adafruit/Adafruit-PyGamer-PCB/README.md

# Adafruit-PyGamer-PCB
PCB files for Adafruit PyGamer

Format is EagleCAD schematic and board layout

For more details, check out the product page at

   * https://www.adafruit.com/product/4242

Adafruit invests time and resources providing this open source design, 
please support Adafruit and open-source hardware by purchasing 
products from Adafruit!

Designed by Adafruit Industries.  
Creative Commons Attribution, Share-Alike license, check license.txt for more information
All text above must be included in any redistribution
