adafruit/Adafruit-PyGamer-PCB/Adafruit PyGamer.sch

## EAGLE design Adafruit PyGamer.sch (2019-05-22)

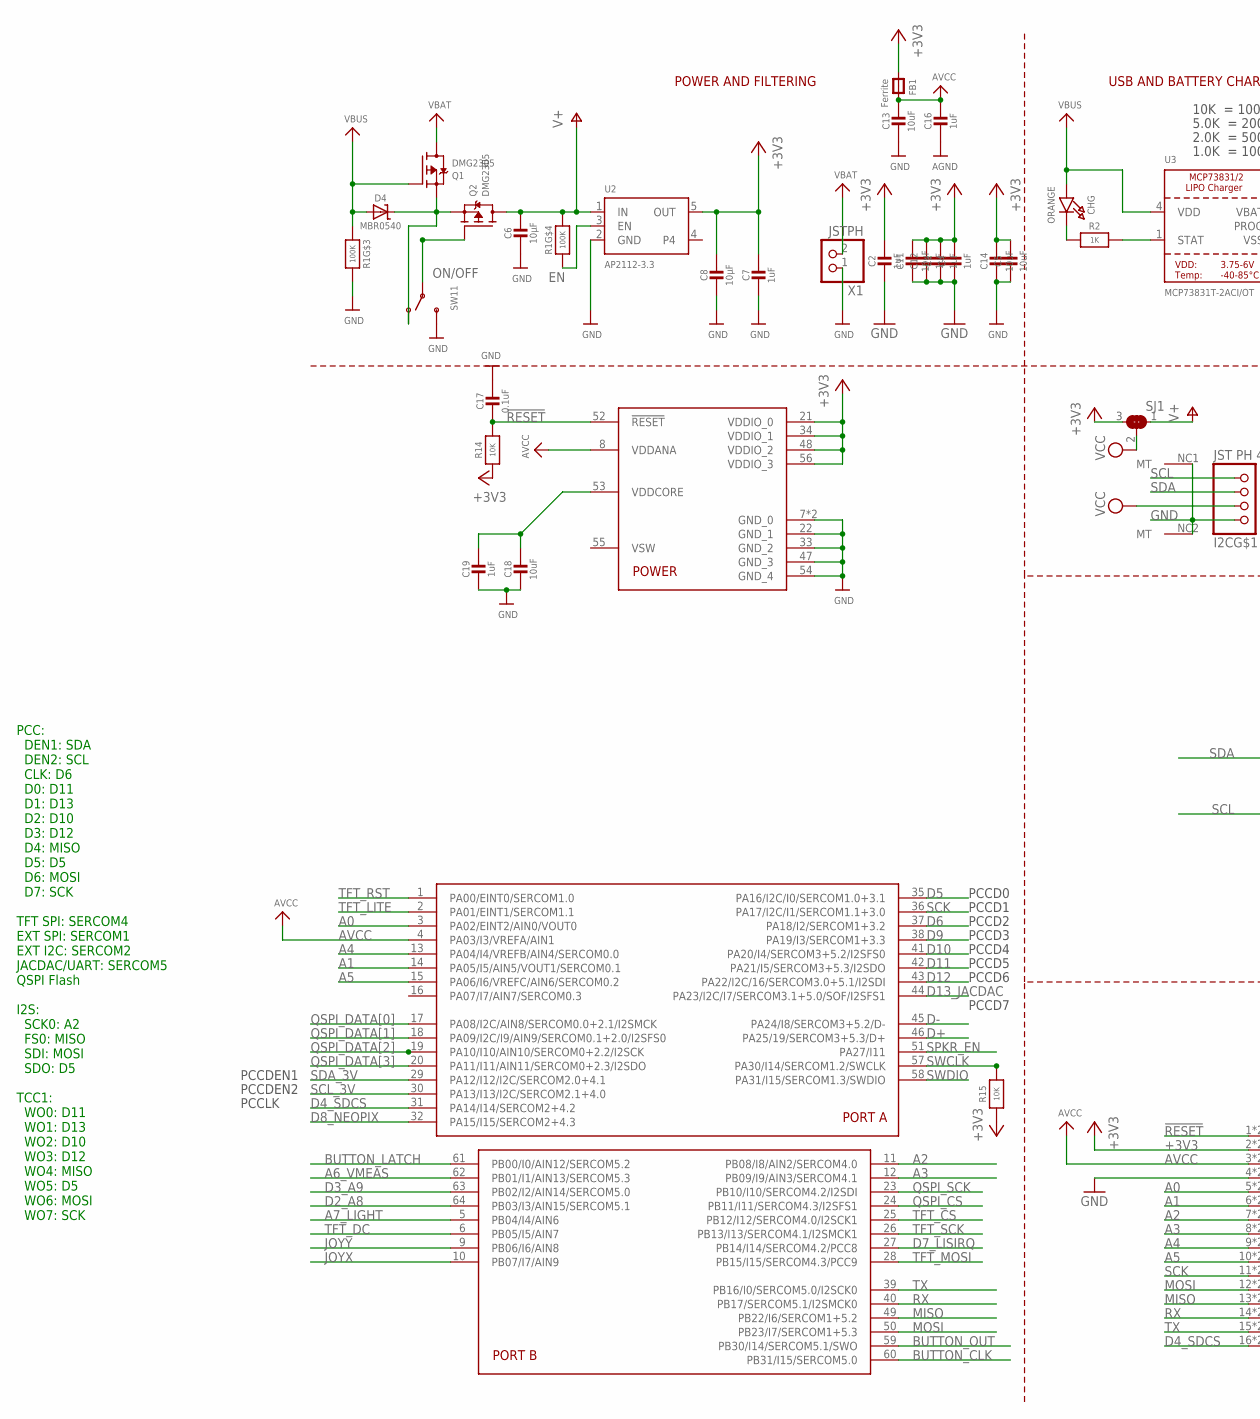
[picture p2: schematic Adafruit PyGamer.sch, sheet 1, part in row 1, column 1]

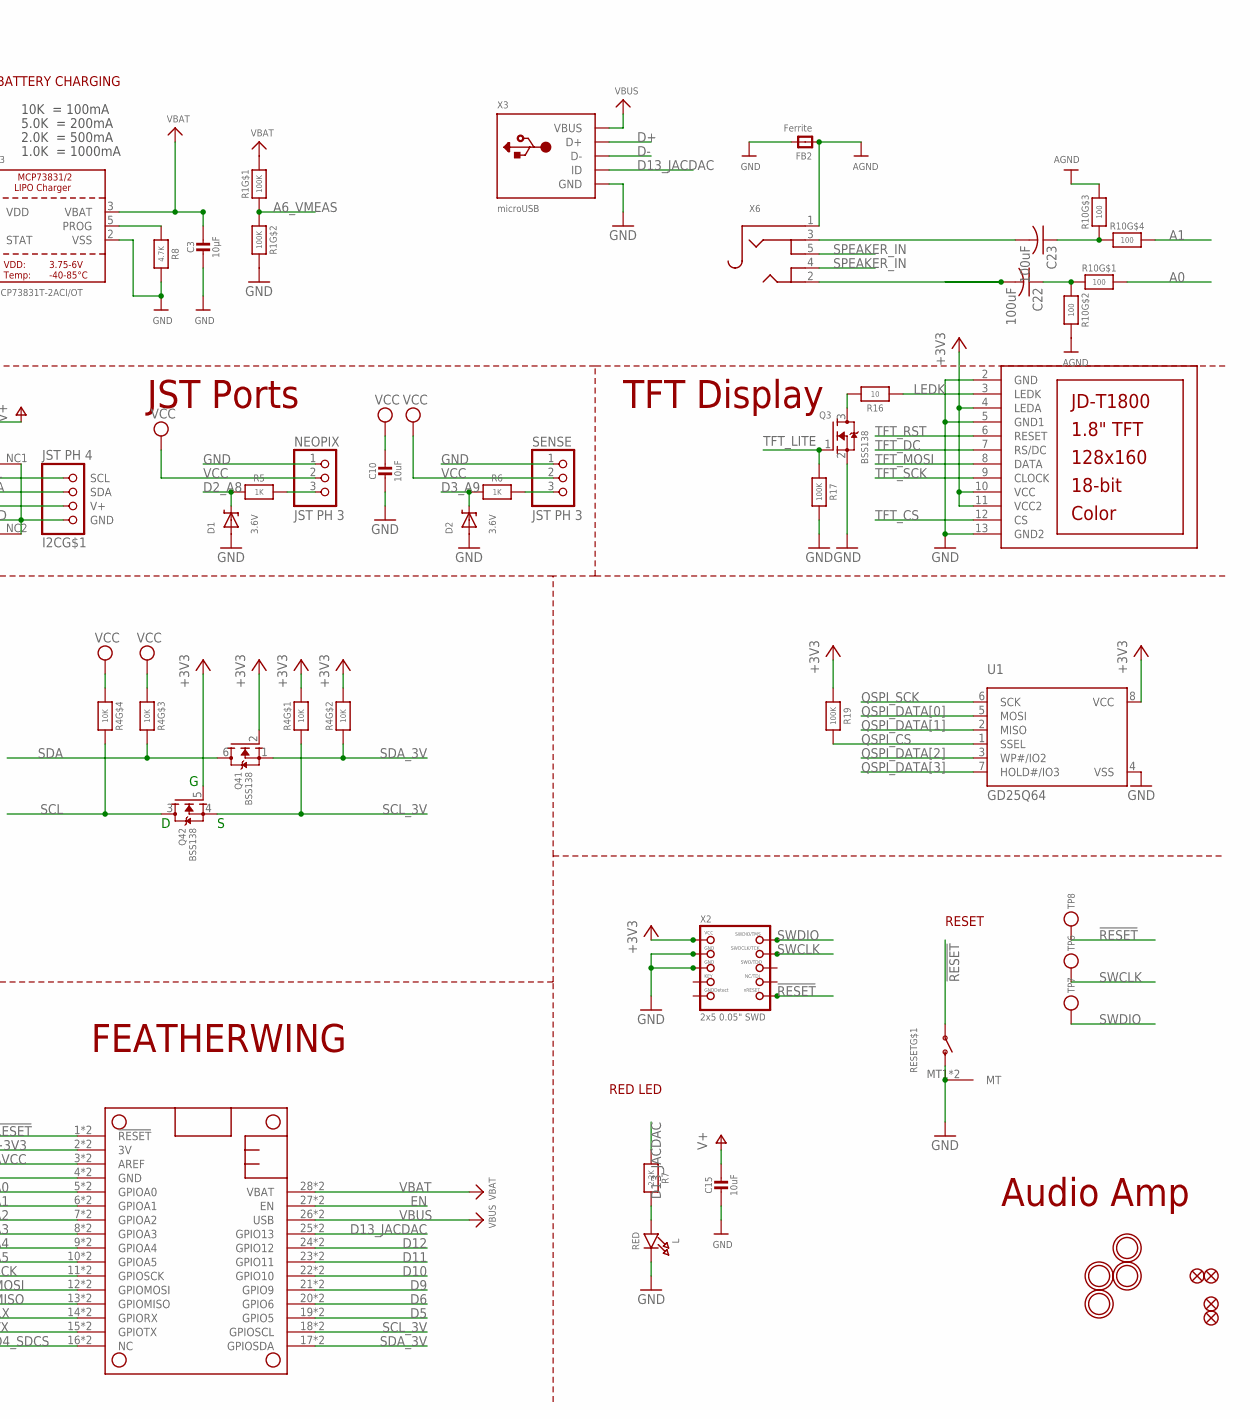
[picture p3: schematic Adafruit PyGamer.sch, sheet 1, part in row 1, column 2]

Parts:
C1, C2, C4, C7, C12, C16, C19: 1uF; 0603-NO
C3, C6, C8: 10µF; 0805-NO
C5, C10, C11, C13, C14, C15, C18: 10uF; 0805-NO
C17: 0.1uF; 0603-NO
C22, C23: 100uF; C1210
CHG: ORANGE; CHIPLED_0805_NOOUTLINE
D1, D2: 3.6V; SOD-323
D4: MBR0540; SOD-123
FB1: Ferrite; 0805-NO
FB2: Ferrite; _0805MP
I2C: JST PH 4; JSTPH4
L: RED; CHIPLED_0805_NOOUTLINE
LCD1: DISP_LCD_JDT1800; JD-T1800
MS1: FEATHERWING_SMTDUALNOHOLES; FEATHERWING_SMT_NOHOLES
NEOPIX: JST PH 3; JSTPH3
Q1, Q2: DMG2305; SOT23-R
Q3: BSS138; SOT23-WIDE
Q4: BSS138; SOT363
R1: 100K; RESPACK_4X0603
R2, R5, R6: 1K; 0603-NO
R4: 10K; RESPACK_4X0603
R7: 2.2K; 0603-NO
R8: 4.7K; 0603-NO
R10: 100; RESPACK_4X0603
R14, R15: 10K; 0603-NO
R16: 10; 0603-NO
R17, R19: 100K; 0603-NO
RESET: SWITCH_SPST_TACT_RA; SPST_TACTILE_RA
SENSE: JST PH 3; JSTPH3
SJ1: SOLDERJUMPER_2WAY; SOLDERJUMPER_2WAY_OPEN_NOPASTE
SW11: SWITCH_SPDT; SPDT_SMT_SSSS811101
TP6, TP7, TP8: TESTPOINTROUND2MMNO; TESTPOINT_ROUND_2MM_NO
U1: GD25Q64; SOIC8_208MIL
U2: AP2112-3.3; SOT23-5
U3: MCP73831T-2ACI/OT; SOT23-5
U$5, U$6, U$17, U$18: MOUNTINGHOLE3.0THIN; MOUNTINGHOLE_3.0_PLATEDTHIN
U$24: ATSAMD51J19; PQFN64-1
U$34, U$35, U$43, U$46: FIDUCIAL_1MM
X1: JSTPH; JSTPH2
X2: 2x5 0.05" SWD; 2X05_1.27MM_BOX_POSTS
X3: microUSB; 4UCONN_20329_V2
X6: AUDIO_3.5MMJACK; 4UCONN_19269

Connections:
!RESET: C17.2, MS1.1 (!RESET), R14.2, RESET.1, TP8.P$1, U$24.52 (!RESET), X2.10 (NRESET)
+3V3: C1.1, C2.1, C4.1, C5.1, C7.1, C8.1, C11.1, C12.1, C14.1, FB1.1, LCD1.4 (LEDA), LCD1.10 (VCC), LCD1.11 (VCC2), MS1.2 (3V), Q4.2 (G), Q4.5 (G), R4.1, R4.2 (1), R14.1, R15.1, R19.1, SJ1.3, U1.8 (VCC), U2.5 (OUT), U$24.21 (VDDIO_0), U$24.34 (VDDIO_1), U$24.48 (VDDIO_2), U$24.56 (VDDIO_3), X2.1 (VCC)
A0: MS1.5 (GPIOA0), R10.8 (2), U$24.3 (PA02/EINT2/AIN0/VOUT0)
A1: MS1.6 (GPIOA1), R10.5 (2), U$24.14 (PA05/I5/AIN5/VOUT1/SERCOM0.1)
A2: MS1.7 (GPIOA2), U$24.11 (PB08/I8/AIN2/SERCOM4.0)
A3: MS1.8 (GPIOA3), U$24.12 (PB09/I9/AIN3/SERCOM4.1)
A4: MS1.9 (GPIOA4), U$24.13 (PA04/I4/VREFB/AIN4/SERCOM0.0)
A5: MS1.10 (GPIOA5), U$24.15 (PA06/I6/VREFC/AIN6/SERCOM0.2)
A6_VMEAS: R1.1, R1.2 (1), U$24.62 (PB01/I1/AIN13/SERCOM5.3)
A7_LIGHT: U$24.5 (PB04/I4/AIN6)
AGND: C16.2, FB2.1, R10.6 (2), R10.7 (2), X6.1
AVCC: C13.1, C16.1, FB1.2, MS1.3 (AREF), U$24.4 (PA03/I3/VREFA/AIN1), U$24.8 (VDDANA)
BUTTON_CLK: U$24.60 (PB31/I15/SERCOM5.0)
BUTTON_LATCH: U$24.61 (PB00/I0/AIN12/SERCOM5.2)
BUTTON_OUT: U$24.59 (PB30/I14/SERCOM5.1/SWO)
CHG_LED: R2.2, U3.1 (STAT)
CHG_RATE: R8.1, U3.5 (PROG)
D2_: NEOPIX.3, R5.1
D2_A8: D1.C, R5.2, U$24.64 (PB03/I3/AIN15/SERCOM5.1)
D3_: R6.1, SENSE.3
D3_A9: D2.C, R6.2, U$24.63 (PB02/I2/AIN14/SERCOM5.0)
D4_SDCS: MS1.16 (NC), U$24.31 (PA14/I14/SERCOM2+4.2)
D5: MS1.19 (GPIO5), U$24.35 (PA16/I2C/I0/SERCOM1.0+3.1)
D6: MS1.20 (GPIO6), U$24.37 (PA18/I2/SERCOM1+3.2)
D7_LISIRQ: U$24.27 (PB14/I14/SERCOM4.2/PCC8)
D8_NEOPIX: U$24.32 (PA15/I15/SERCOM2+4.3)
D9: MS1.21 (GPIO9), U$24.38 (PA19/I3/SERCOM1+3.3)
D10: MS1.22 (GPIO10), U$24.41 (PA20/I4/SERCOM3+5.2/I2SFS0)
D11: MS1.23 (GPIO11), U$24.42 (PA21/I5/SERCOM3+5.3/I2SDO)
D12: MS1.24 (GPIO12), U$24.43 (PA22/I2C/16/SERCOM3.0+5.1/I2SDI)
D13_JACDAC: MS1.25 (GPIO13), R7.1, U$24.44 (PA23/I2C/I7/SERCOM3.1+5.0/SOF/I2SFS1), X3.ID
D+: U$24.46 (PA25/19/SERCOM3+5.3/D+), X3.D+
D-: U$24.45 (PA24/I8/SERCOM3+5.2/D-), X3.D-
EN: MS1.27 (EN), R1.4 (1), U2.3 (EN)
GND: C1.2, C2.2, C3.2, C4.2, C5.2, C6.2, C7.2, C8.2, C10.2, C11.2, C12.2, C13.2, C14.2, C15.2, C17.1, C18.2, C19.2, D1.A, D2.A, FB2.2, I2C.1 (GND), I2C.NC1 (MT), I2C.NC2 (MT), L.C, LCD1.2 (GND), LCD1.5 (GND1), LCD1.13 (GND2), MS1.4 (GND), NEOPIX.1, Q3.2 (S), R1.6 (2), R1.7 (2), R8.2, R17.2, RESET.2 (S), RESET.MT1 (MT), SENSE.1, SW11.C (S), U1.4 (VSS), U2.2 (GND), U3.2 (VSS), U$24.7 (GND_0), U$24.22 (GND_1), U$24.33 (GND_2), U$24.47 (GND_3), U$24.54 (GND_4), X1.1, X2.3 (GND), X2.5 (GND), X3.BASE@1 (GND)
JOYX: U$24.10 (PB07/I7/AIN9)
JOYY: U$24.9 (PB06/I6/AIN8)
LEDK: LCD1.3 (LEDK), R16.1
MISO: MS1.13 (GPIOMISO), U$24.49 (PB22/I6/SERCOM1+5.2)
MOSI: MS1.12 (GPIOMOSI), U$24.50 (PB23/I7/SERCOM1+5.3)
unnamed: CHG.C, R2.1
unnamed: L.A, R7.2
unnamed: Q3.3 (D), R16.2
unnamed: D4.C, Q1.2 (S), Q2.2 (S), SW11.A (O)
unnamed: C23.2, X6.3
unnamed: C22.2, X6.2
unnamed: C23.1, R10.3 (1), R10.4 (1)
unnamed: C22.1, R10.1, R10.2 (1)
ON/OFF: Q2.1 (G), SW11.B
QSPI_CS: R19.2, U1.1 (SSEL), U$24.24 (PB11/I11/SERCOM4.3/I2SFS1)
QSPI_DATA[0]: U1.5 (MOSI), U$24.17 (PA08/I2C/AIN8/SERCOM0.0+2.1/I2SMCK)
QSPI_DATA[1]: U1.2 (MISO), U$24.18 (PA09/I2C/I9/AIN9/SERCOM0.1+2.0/I2SFS0)
QSPI_DATA[2]: U1.3 (WP#/IO2), U$24.19 (PA10/I10/AIN10/SERCOM0+2.2/I2SCK)
QSPI_DATA[3]: U1.7 (HOLD#/IO3), U$24.20 (PA11/I11/AIN11/SERCOM0+2.3/I2SDO)
QSPI_SCK: U1.6 (SCK), U$24.23 (PB10/I10/SERCOM4.2/I2SDI)
RX: MS1.14 (GPIORX), U$24.40 (PB17/SERCOM5.1/I2SMCK0)
SCK: MS1.11 (GPIOSCK), U$24.36 (PA17/I2C/I1/SERCOM1.1+3.0)
SCL: I2C.4 (SCL), Q4.3 (D), R4.5 (2)
SCL_3V: MS1.18 (GPIOSCL), Q4.4 (S), R4.8 (2), U$24.30 (PA13/I13/I2C/SERCOM2.1+4.0)
SDA: I2C.3 (SDA), Q4.6 (D), R4.6 (2)
SDA_3V: MS1.17 (GPIOSDA), Q4.1 (S), R4.7 (2), U$24.29 (PA12/I12/I2C/SERCOM2.0+4.1)
SPEAKER_IN: X6.4, X6.5
SPKR_EN: U$24.51 (PA27/I11)
SWCLK: R15.2, TP6.P$1, U$24.57 (PA30/I14/SERCOM1.2/SWCLK), X2.4 (SWDCLK)
SWDIO: TP7.P$1, U$24.58 (PA31/I15/SERCOM1.3/SWDIO), X2.2 (SWDIO)
TFT_CS: LCD1.12 (CS), U$24.25 (PB12/I12/SERCOM4.0/I2SCK1)
TFT_DC: LCD1.7 (RS/DC), U$24.6 (PB05/I5/AIN7)
TFT_LITE: Q3.1 (G), R17.1, U$24.2 (PA01/EINT1/SERCOM1.1)
TFT_MOSI: LCD1.8 (DATA), U$24.28 (PB15/I15/SERCOM4.3/PCC9)
TFT_RST: LCD1.6 (RESET), U$24.1 (PA00/EINT0/SERCOM1.0)
TFT_SCK: LCD1.9 (CLOCK), U$24.26 (PB13/I13/SERCOM4.1/I2SMCK1)
TX: MS1.15 (GPIOTX), U$24.39 (PB16/I0/SERCOM5.0/I2SCK0)
V+: C6.1, C15.1, Q2.3 (D), R1.5 (2), SJ1.1, U2.1 (IN)
VBAT: C3.1, MS1.28 (VBAT), Q1.3 (D), R1.8 (2), U3.3 (VBAT), X1.2
VBUS: CHG.A, D4.A, MS1.26 (USB), Q1.1 (G), R1.3 (1), U3.4 (VDD), X3.VBUS
VCC: C10.1, I2C.2 (V+), NEOPIX.2, R4.3 (1), R4.4 (1), SENSE.2, SJ1.2
VDDCORE2: C18.1, C19.1, U$24.53 (VDDCORE)

Notes on the sheet:
POWER AND FILTERING
RESET
10K = 100mA
5.0K = 200mA
2.0K = 500mA
1.0K = 1000mA
USB AND BATTERY CHARGING
RED LED
FEATHERWING
TFT Display
Audio Amp
JST Ports
PCCDEN1
PCCDEN2
PCCD0
PCCD1
PCCD2
PCCD3
PCCD4
PCCD5
PCCD6
PCCD7
PCCLK
PCC: DEN1: SDA DEN2: SCL CLK: D6 D0: D11 D1: D13 D2: D10 D3: D12 D4: MISO D5: D5 D6: MOSI D7: SCK TFT SPI: SERCOM4 EXT SPI: SERCOM1 EXT I2C: SERCOM2 JACDAC/UART: SERCOM5 QSPI Flash I2S: SCK0: A2 FS0: MISO SDI: MOSI SDO: D5 TCC1: WO0: D11 WO1: D13 WO2: D10 WO3: D12 WO4: MISO WO5: D5 WO6: MOSI WO7: S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

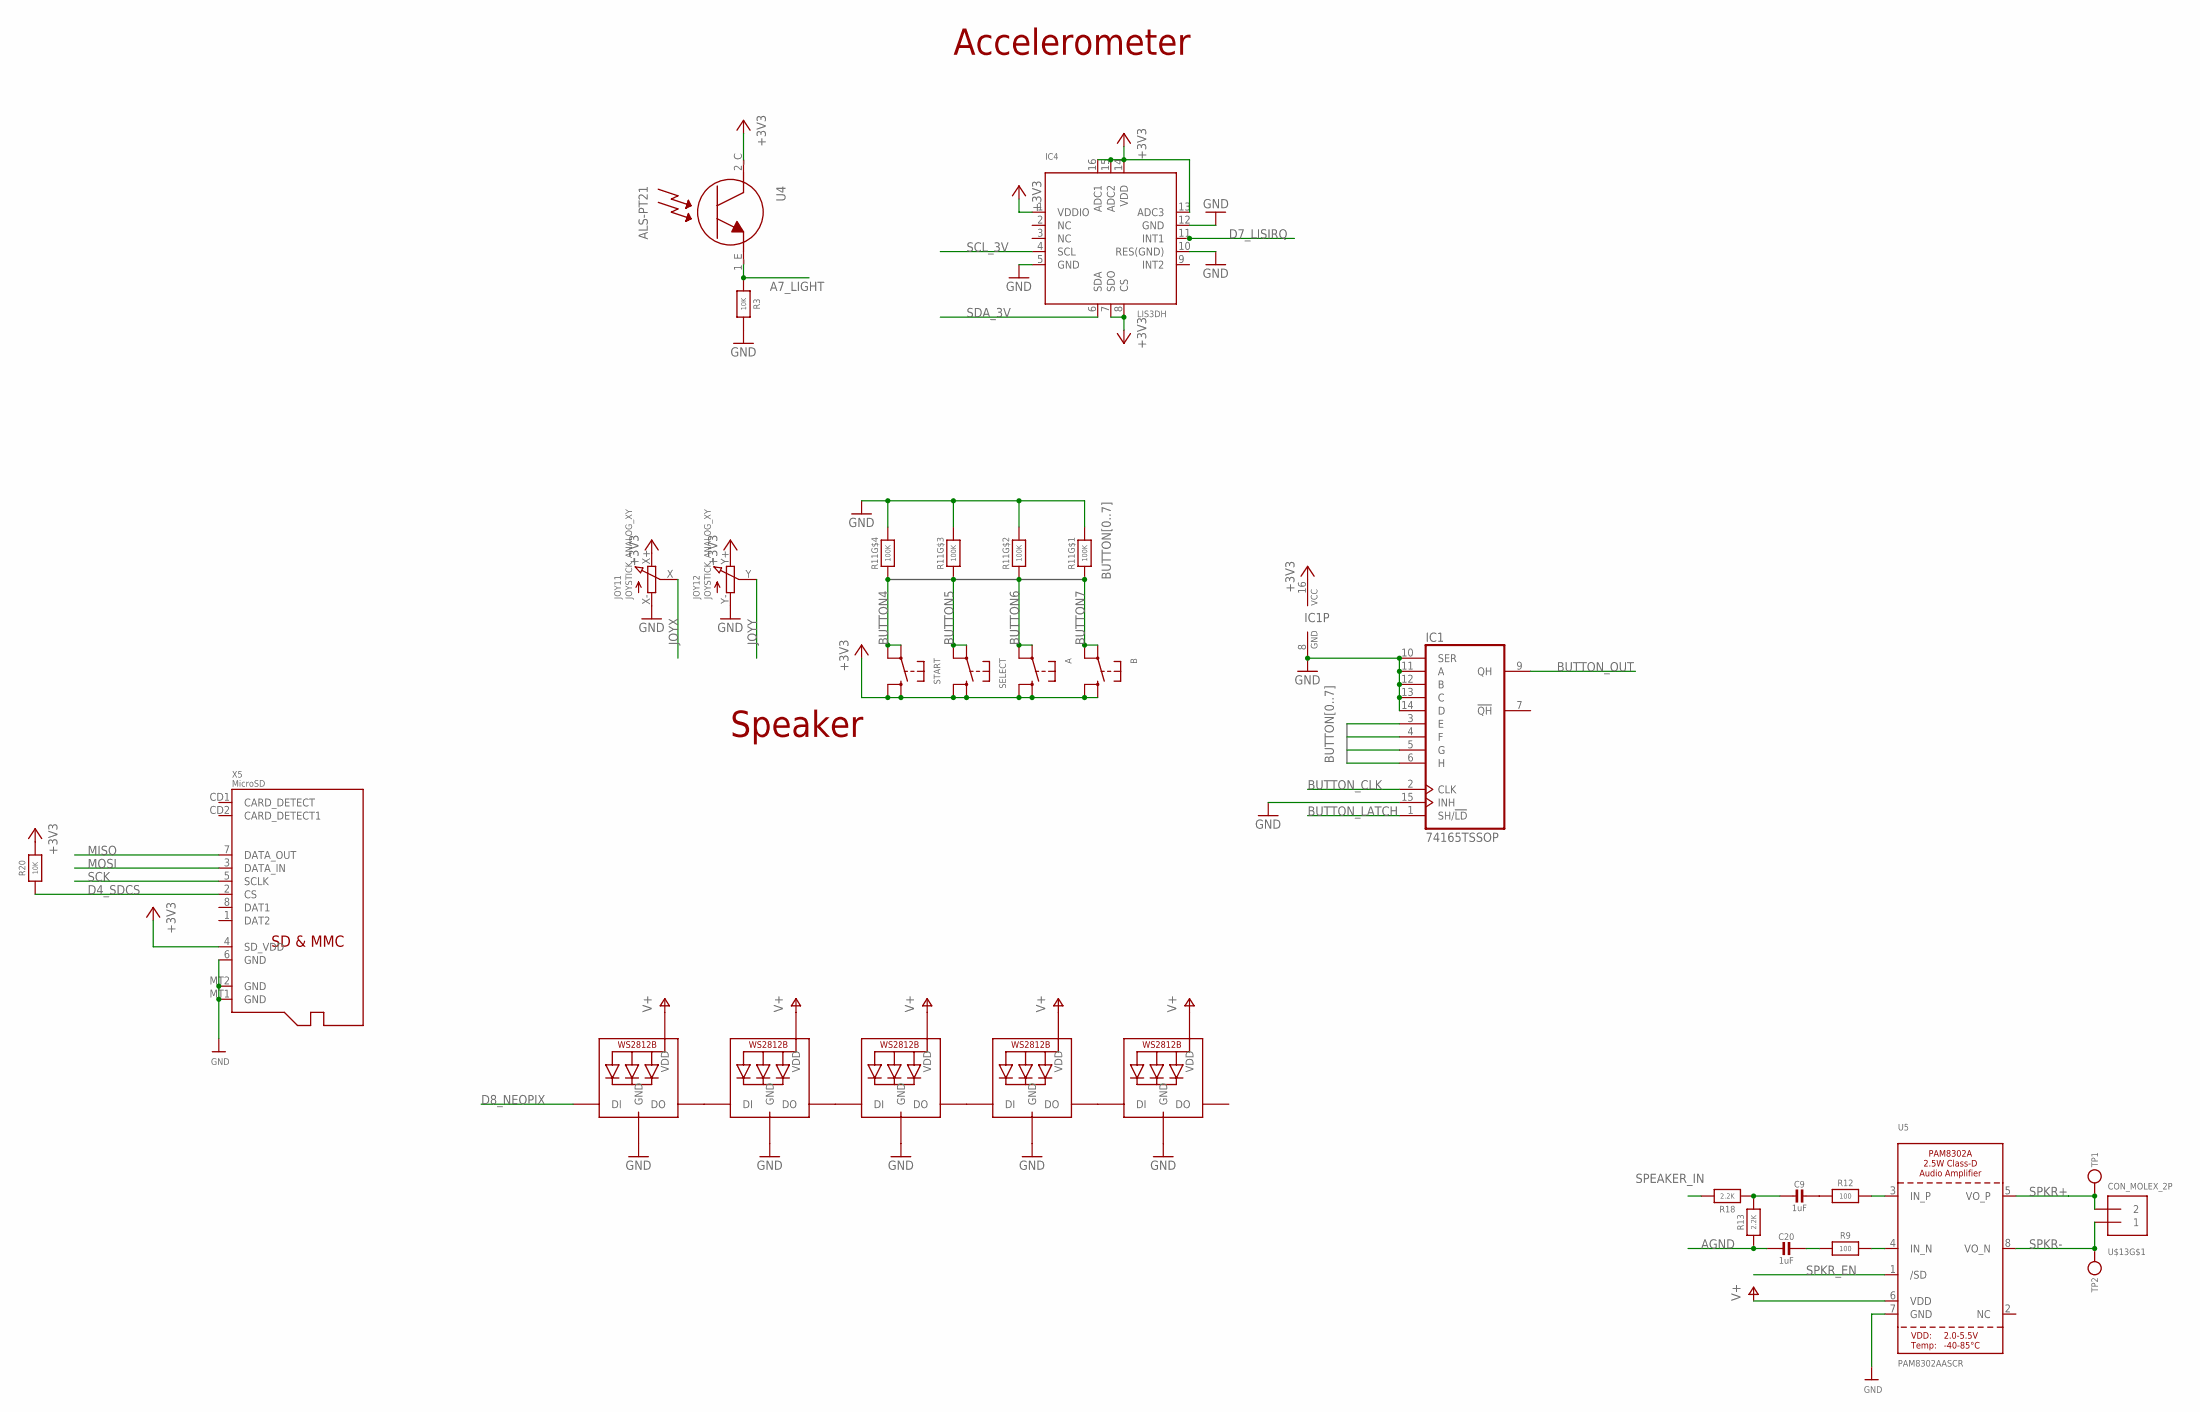
[picture p4: schematic Adafruit PyGamer.sch, sheet 2]

Parts:
A: SWITCH_TACT_SMT_6MM8MMCAP; 6MM_SMT_6MMCAP
B: SWITCH_TACT_SMT_6MM8MMCAP; 6MM_SMT_6MMCAP
C9, C20: 1uF; 0603-NO
IC1: 74165TSSOP; TSSOP16
IC4: LIS3DH; LGA16_3X3MM
JOY1: JOYSTICK_ANALOG_XY; JOYSTICK_ANALOG_MINITHM
LED1, LED2, LED3, LED4, LED5: WS2812B3535; LED3535
R3, R20: 10K; 0603-NO
R9, R12: 100; 0603-NO
R11: 100K; RESPACK_4X0603
R13, R18: 2.2K; 0603-NO
SELECT: SWITCH_TACT_SMT_6MM8MMCAP; 6MM_SMT_6MMCAP
START: SWITCH_TACT_SMT_6MM8MMCAP; 6MM_SMT_6MMCAP
TP1, TP2: TESTPOINTROUND1.5MMNO; TESTPOINT_ROUND_1.5MM_NO
U4: ALS-PT21; ALS-PT26-21C
U5: PAM8302AASCR; MSOP8_0.65MM
U$13: CON_MOLEX_2P; 53398-0271
X5: MicroSD; MICROSD

Connections:
+3V3: A.B (S), A.B' (S1), B.B (S), B.B' (S1), IC1.16 (VCC), IC4.1 (VDDIO), IC4.7 (SDO), IC4.8 (CS), IC4.13 (ADC3), IC4.14 (VDD), IC4.15 (ADC2), IC4.16 (ADC1), JOY1.X+ (E), JOY1.Y+ (E), R20.2, SELECT.B (S), SELECT.B' (S1), START.B (S), START.B' (S1), U4.2_C (C), X5.4 (SD_VDD)
A7_LIGHT: R3.2, U4.1_E (E)
AGND: C20.2, R13.1
BUTTON4: IC1.3 (E), R11.4 (1), START.A, START.A' (P1)
BUTTON5: IC1.4 (F), R11.3 (1), SELECT.A, SELECT.A' (P1)
BUTTON6: A.A, A.A' (P1), IC1.5 (G), R11.2 (1)
BUTTON7: B.A, B.A' (P1), IC1.6 (H), R11.1
BUTTON_CLK: IC1.2 (CLK)
BUTTON_LATCH: IC1.1 (SH/!LD)
BUTTON_OUT: IC1.9 (QH)
D4_SDCS: R20.1, X5.2 (CS)
D7_LISIRQ: IC4.11 (INT1)
D8_NEOPIX: LED1.1 (DI)
GND: IC1.8 (GND), IC1.10 (SER), IC1.11 (A), IC1.12 (B), IC1.13 (C), IC1.14 (D), IC1.15 (INH), IC4.5 (GND), IC4.10 (RES(GND)), IC4.12 (GND), JOY1.X- (A), JOY1.Y- (A), LED1.4 (GND), LED2.4 (GND), LED3.4 (GND), LED4.4 (GND), LED5.4 (GND), R3.1, R11.5 (2), R11.6 (2), R11.7 (2), R11.8 (2), U5.7 (GND), X5.6 (GND), X5.MT1 (GND), X5.MT2 (GND)
JOYX: JOY1.X (S)
JOYY: JOY1.Y (S)
MISO: X5.7 (DATA_OUT)
MOSI: X5.3 (DATA_IN)
unnamed: LED1.3 (DO), LED2.1 (DI)
unnamed: LED2.3 (DO), LED3.1 (DI)
unnamed: LED3.3 (DO), LED4.1 (DI)
unnamed: LED4.3 (DO), LED5.1 (DI)
unnamed: R9.2, U5.4 (IN_N)
unnamed: R12.2, U5.3 (IN_P)
unnamed: C9.2, R13.2, R18.1
unnamed: C20.1, R9.1
unnamed: C9.1, R12.1
SCK: X5.5 (SCLK)
SCL_3V: IC4.4 (SCL)
SDA_3V: IC4.6 (SDA)
SPEAKER_IN: R18.2
SPKR+: TP1.P$1, U5.5 (VO_P), U$13.2
SPKR-: TP2.P$1, U5.8 (VO_N), U$13.1
SPKR_EN: U5.1 (/SD)
V+: LED1.2 (VDD), LED2.2 (VDD), LED3.2 (VDD), LED4.2 (VDD), LED5.2 (VDD), U5.6 (VDD)

Notes on the sheet:
Speaker
Accelerometer
